Kanope/DIY_PM/Documentation/Kit/Images/Arduino.webp

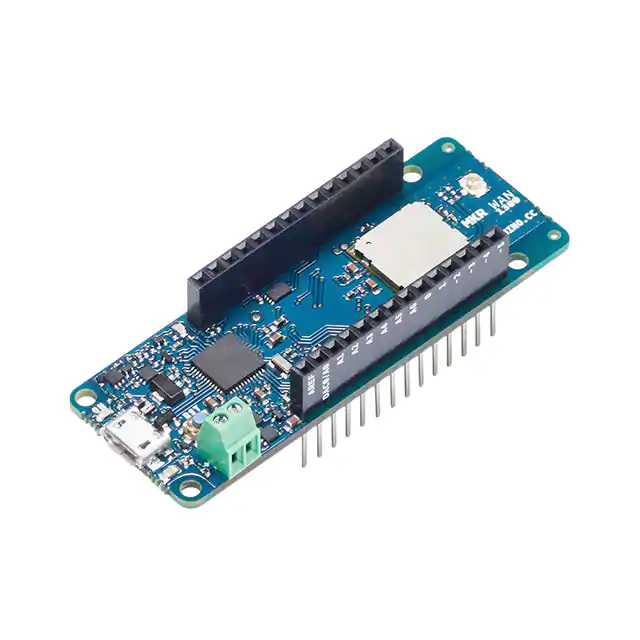
Documentation/Kit/Images/Arduino.webp
