Kanope/DIY_PM/Presentation du projet.pdf

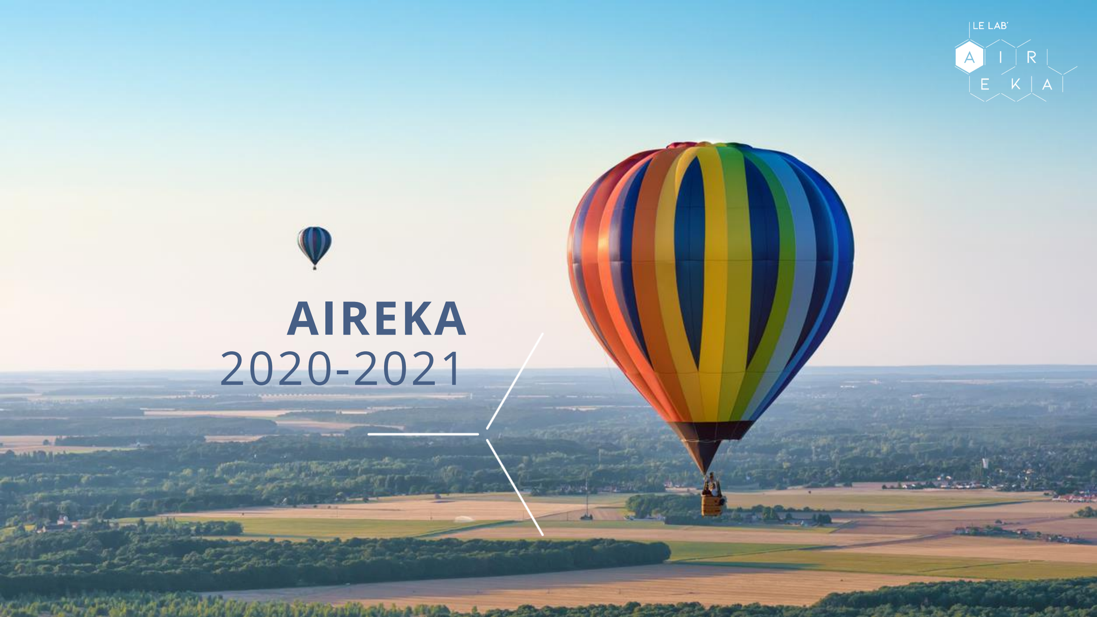
[picture p2: page 1]

## AIREKA

2020-2021

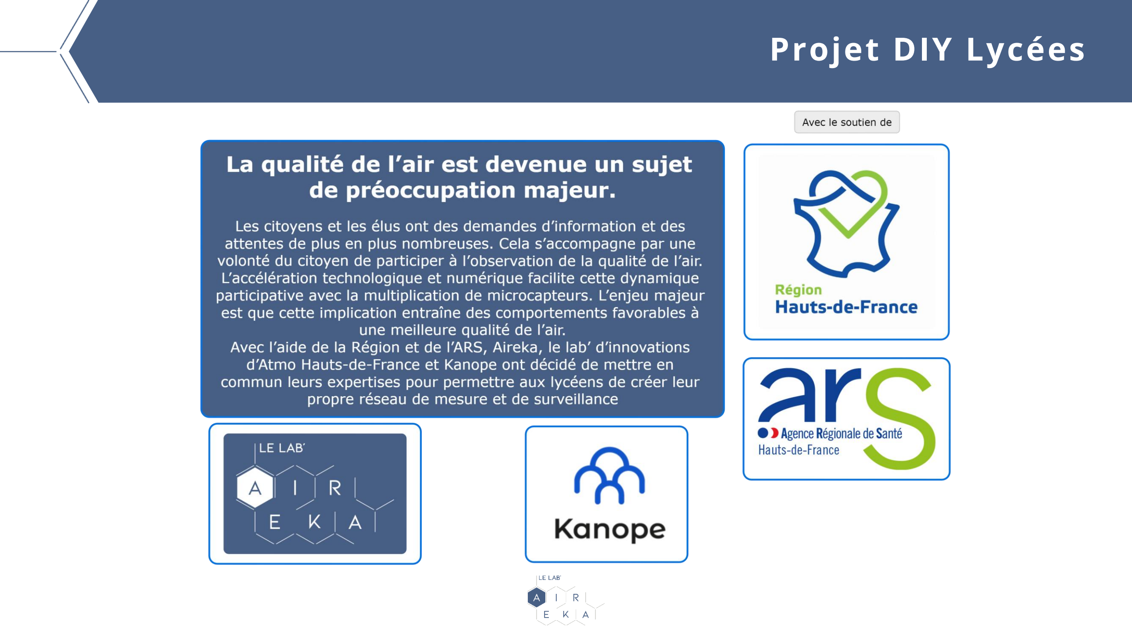
[picture p3: page 2]

Projet DIY Lycées

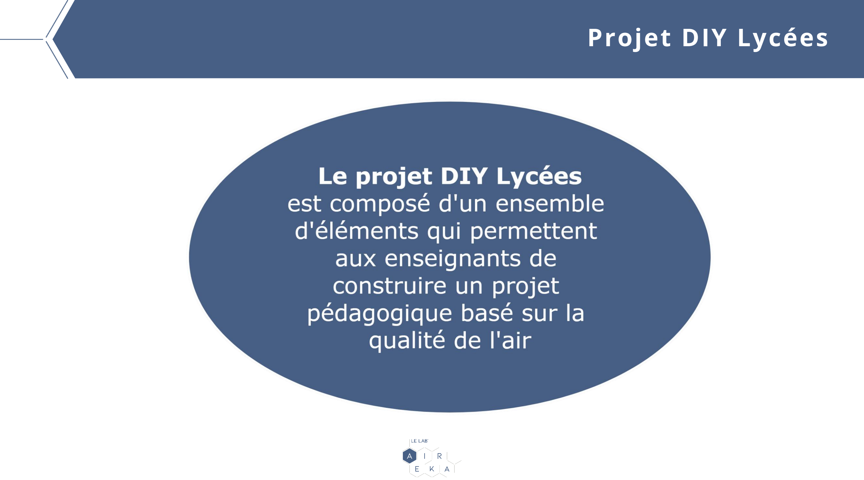
[picture p4: page 3]

Projet DIY Lycées

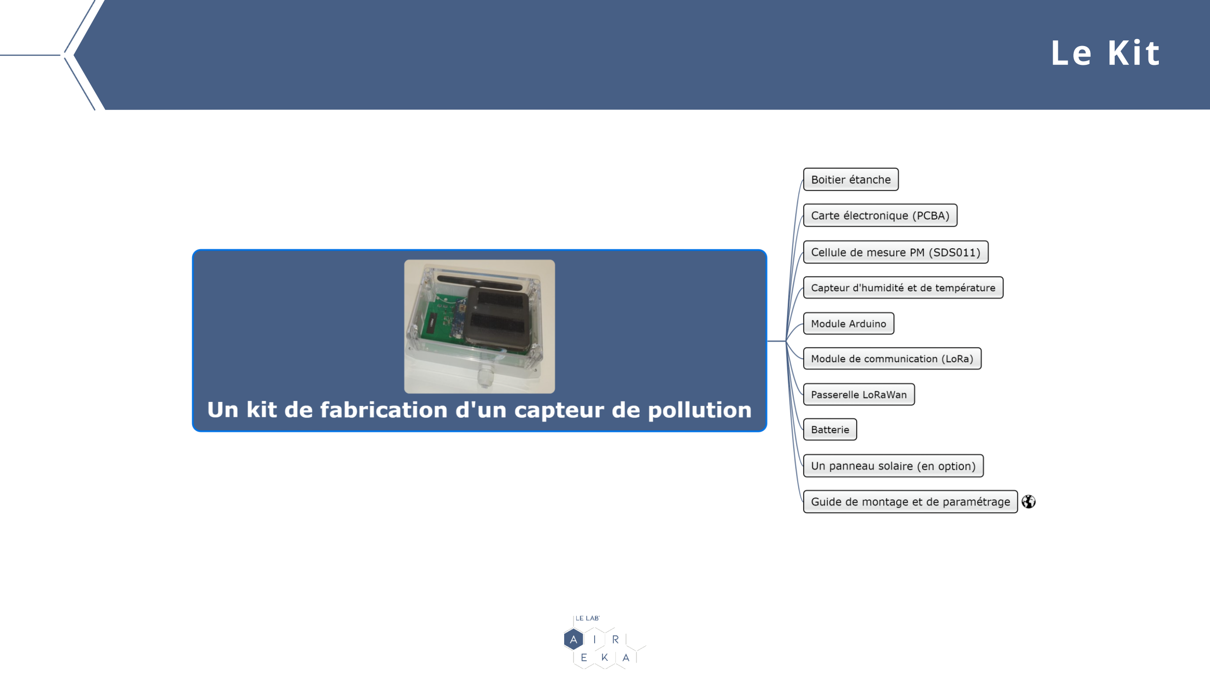
[picture p5: page 4]

Le Kit

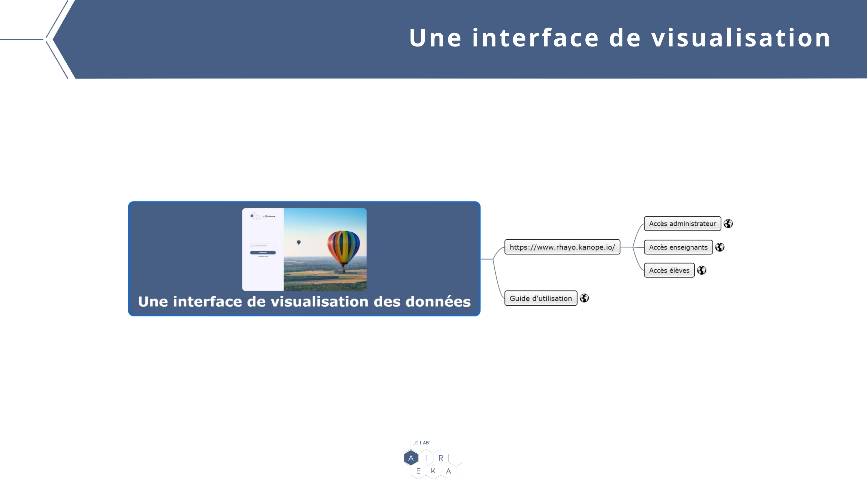
[picture p6: page 5]

Une interface de visualisation

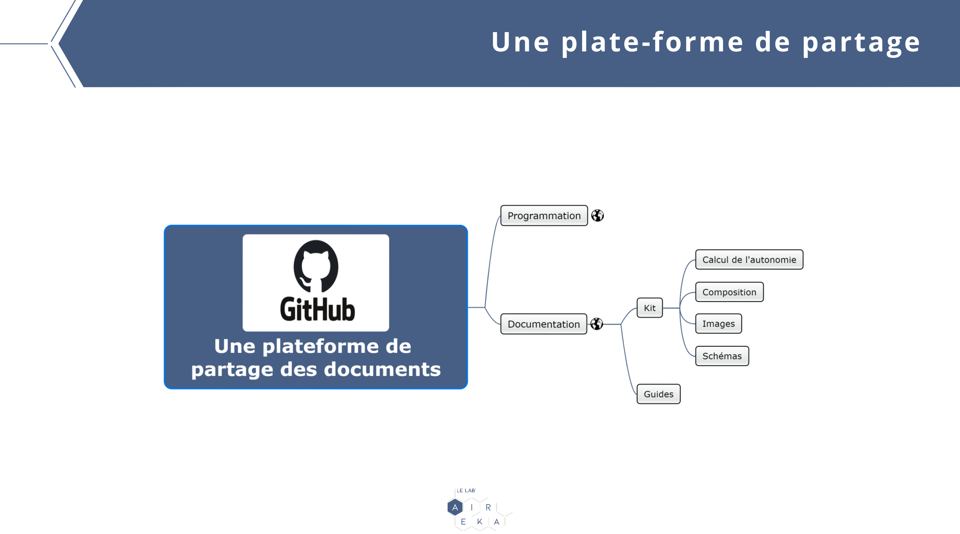
[picture p7: page 6]

Une plate-forme de partage

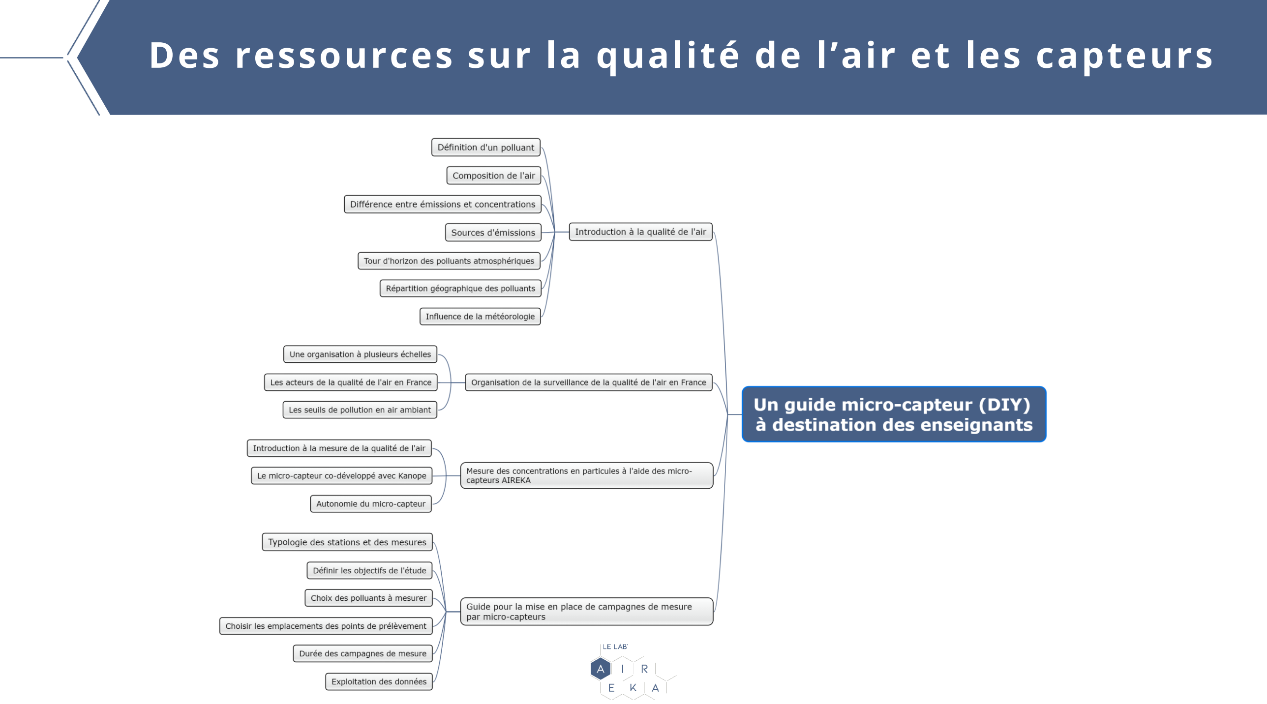
[picture p8: page 7]

Des ressources sur la qualité de l’air et les capteurs

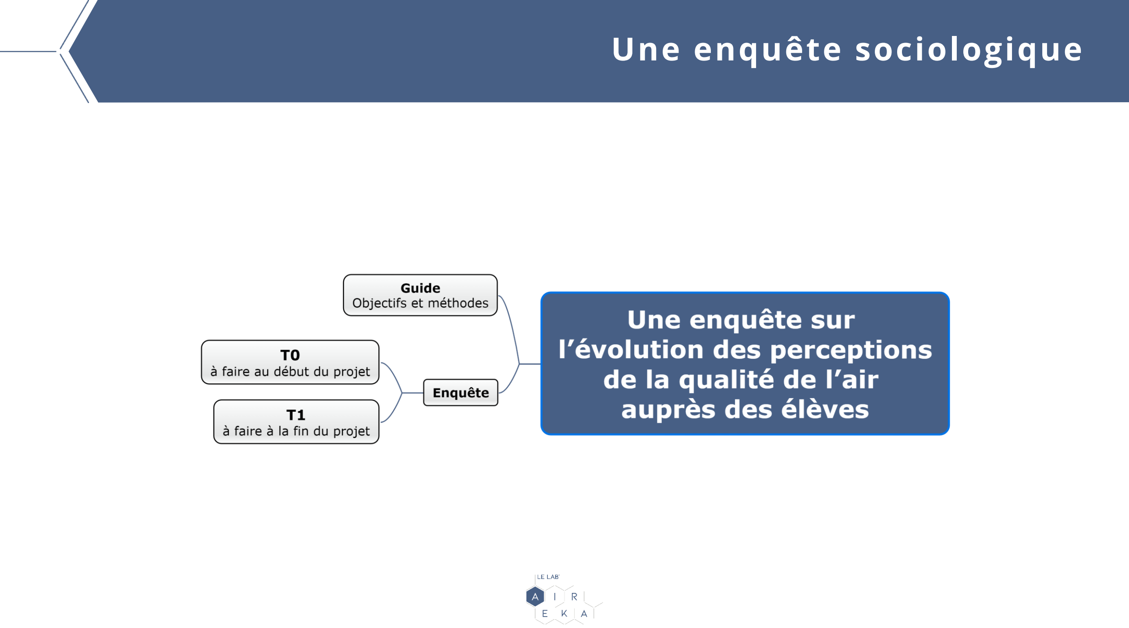
[picture p9: page 8]

Une enquête sociologique
