Kanope/DIY_PM/Documentation/Kit/Images/antenne lora.webp

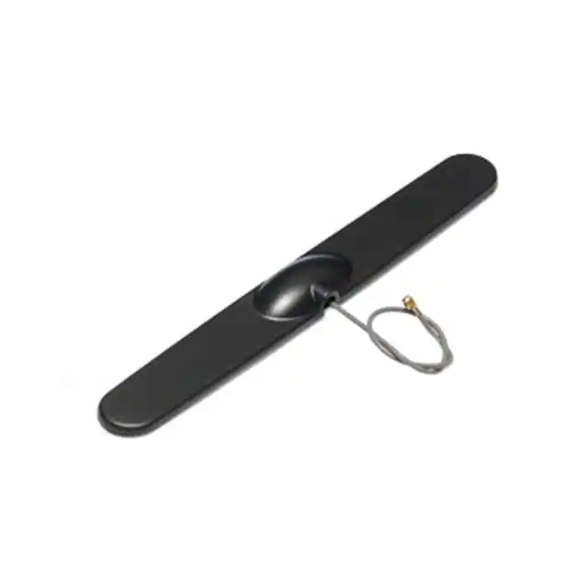
Documentation/Kit/Images/antenne lora.webp
