Kanope/DIY_PM/Documentation/Kit/Images/boitier.jpg

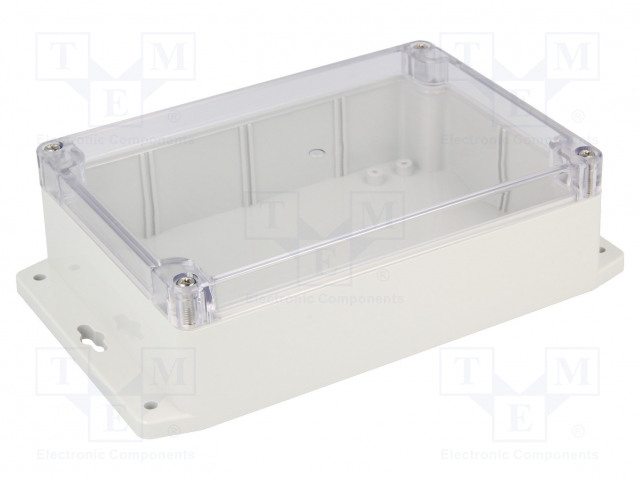
Documentation/Kit/Images/boitier.jpg
