Kanope/DIY_PM/Documentation/Kit/Images/capteur humidite-temperature.webp

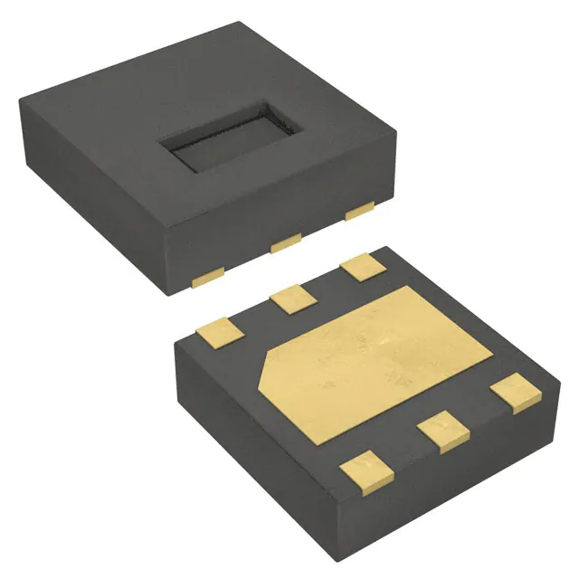
Documentation/Kit/Images/capteur humidite-temperature.webp
