Kanope/DIY_PM/Documentation/Kit/Images/cellule-mesure-SDS011.jpg

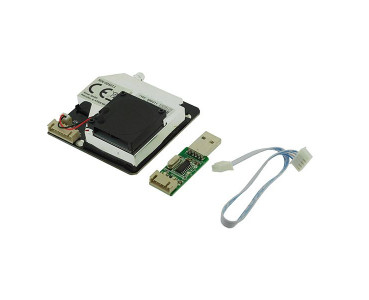
Documentation/Kit/Images/cellule-mesure-SDS011.jpg
