Kanope/DIY_PM/Documentation/Kit/Images/ecrou.webp

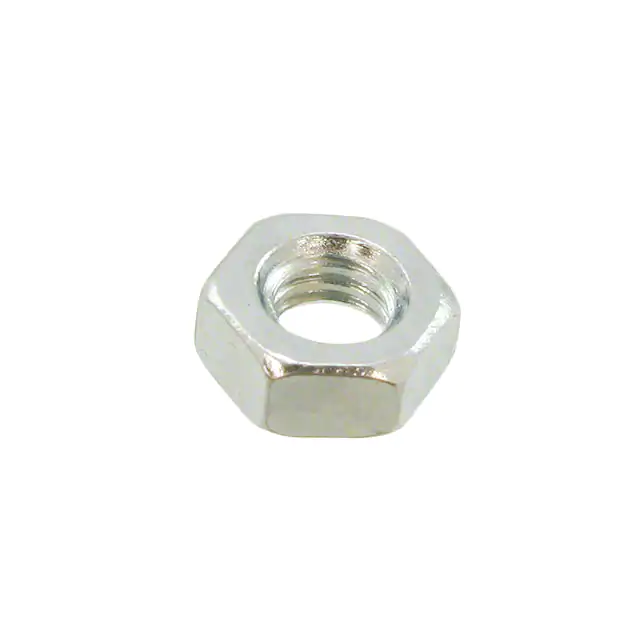
Documentation/Kit/Images/ecrou.webp
