Kanope/DIY_PM/Documentation/Kit/Images/entretoise.webp

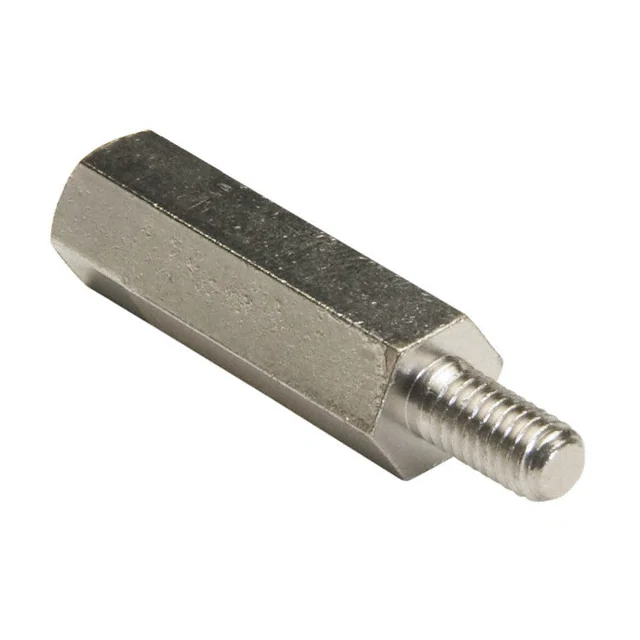
Documentation/Kit/Images/entretoise.webp
