Kanope/DIY_PM/Documentation/Kit/Images/powerbank.jpg

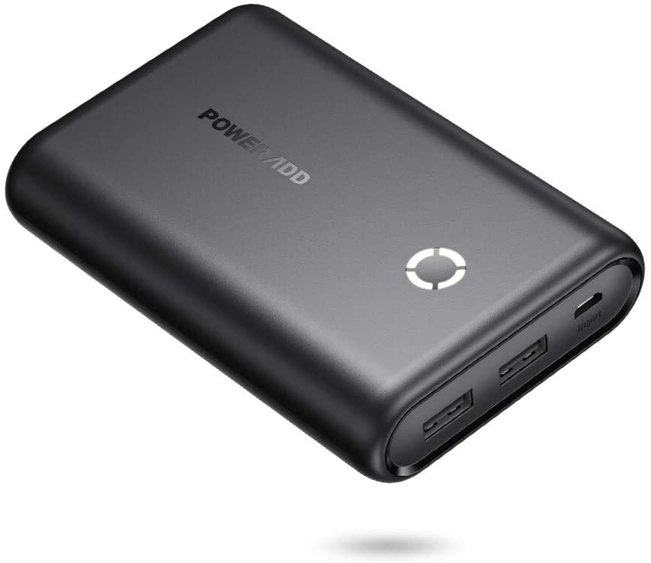
Documentation/Kit/Images/powerbank.jpg
