Kanope/DIY_PM/Documentation/Kit/Images/presse-etoupe.jpg

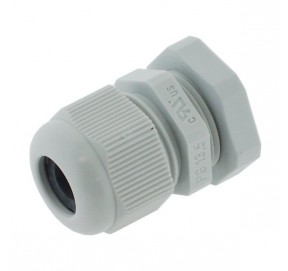
Documentation/Kit/Images/presse-etoupe.jpg
