Kanope/DIY_PM/Documentation/Kit/Images/tube.jpg

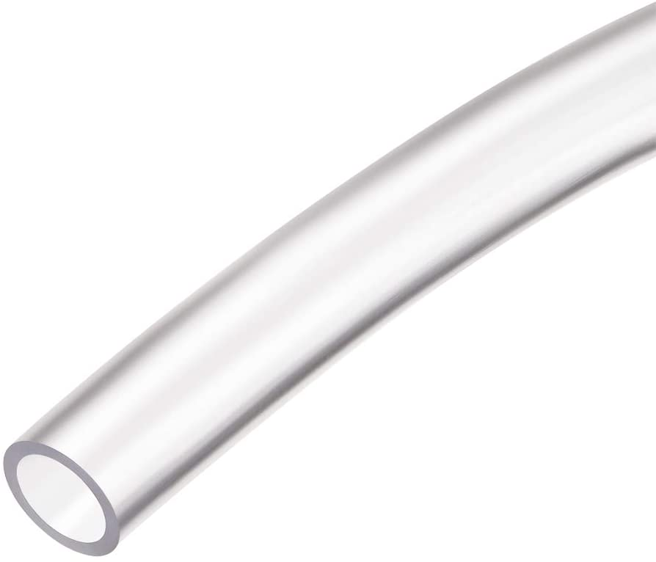
Documentation/Kit/Images/tube.jpg
