Kanope/DIY_PM/Documentation/Kit/Composition/BOM_20210106.xlsx

Référence fabricant | Fabricant | Référence Digi-Key | Référence client | Quantité | Prix unitaire | Montant | Description | Statut RoHS
RC0603FR-071KL | Yageo | 311-1.00KHRCT-ND | R9, R12 | 2 | 0,08000 | 0,16 € | RES SMD 1K OHM 1% 1/10W 0603 | Conforme à RoHS 3
RC0603FR-0710KL | Yageo | 311-10.0KHRCT-ND | R3, R4, R7, R8, R10, R11 | 6 | 0,08000 | 0,48 € | RES SMD 10K OHM 1% 1/10W 0603 | Conforme à RoHS 3
12105C106KAT2A | AVX Corporation | 478-9912-1-ND | C24, C27, C29, C30 | 4 | 0,73000 | 2,92 € | CAP CER 10UF 50V X7R 1210 | Conforme à RoHS 3
12103D226KAT2A | AVX Corporation | 478-5999-1-ND | C1, C2, C3 | 3 | 1,23000 | 3,69 € | CAP CER 22UF 25V X5R 1210 | Conforme à RoHS 3
C0603C104Z3VACTU | KEMET | 399-1100-1-ND | C4, C5, C6, C16 | 4 | 0,08000 | 0,32 € | CAP CER 0.1UF 25V Y5V 0603 | Conforme à RoHS 3
CL10A105KO8NNNC | Samsung Electro-Mechanics | 1276-1034-1-ND | C15, C25, C28 | 3 | 0,08000 | 0,24 € | CAP CER 1UF 16V X5R 0603 | Conforme à RoHS 3
2N7002K-T1-E3 | Vishay Siliconix | 2N7002K-T1-E3CT-ND | Q1 | 1 | 0,19000 | 0,19 € | MOSFET N-CH 60V 300MA SOT-23 | Conforme à RoHS 3
C0603C472K4RECAUTO | KEMET | 399-17879-1-ND | C23, C26 | 2 | 0,13000 | 0,26 € | CAP CER 0603 4.7NF 16V X7R 10% | Conforme à RoHS 3
TPS27081ADDCR | Texas Instruments | 296-34970-1-ND | U5, U6 | 2 | 0,65000 | 1,30 € | IC PWR SWITCH 1:1 TSOT23-6 | Conforme à RoHS 3
TXS0102DCTT | Texas Instruments | 296-32603-1-ND | U1 | 1 | 0,61000 | 0,61 € | IC TRNSLTR BIDIRECTIONAL SM8 | Conforme à RoHS 3
BLM18PG471SN1D | Murata Electronics | 490-5223-1-ND | L1, L2, L3 | 3 | 0,08000 | 0,24 € | FERRITE BEAD 470 OHM 0603 1LN | Conforme à RoHS 3
HPP845E031R5 | TE Connectivity Measurement Specialties | 223-1591-1-ND | U3 | 1 | 3,13000 | 3,13 € | SENSOR HUMID/TEMP 3V I2C 3% SMD | Conforme à RoHS 3
352212RJT | TE Connectivity Passive Product | A121136CT-ND | R1, R2 | 2 | 0,47000 | 0,94 € | RES SMD 12 OHM 5% 3W 2512 | Conforme à RoHS
SDS011 | 35853 | N/A | SDS1 | 1 | 34,91 | 34,91 | Detector of PM2.5;Purifier. | Conforme à RoHS 3 | https://www.gotronic.fr/art-capteur-de-qualite-de-l-air-sds011-27929.htm
0022284023 | Molex | WM50016-02-ND | P1, P2 | 2 | 0,16000 | 0,32 € | CONN HEADER VERT 2POS 2.54MM | Conforme à RoHS 3
PPTC151LFBN-RC | Sullins Connector Solutions | S7013-ND | JP1, JP2 | 2 | 3,88000 | 7,76 € | CONN HEADER VERT 15POS 2.54MM | Conforme à RoHS
61300511121 | Würth Elektronik | 732-5318-ND | J1 | 1 | 0,21000 | 0,21 € | CONN HEADER VERT 5POS 2.54MM | Conforme à RoHS 3
PH1-07-UA | Adam Tech | 2057-PH1-07-UA-ND | J2 | 1 | 0,11000 | 0,11 € | CONN HEADER VERT 7POS 2.54MM | Conforme à RoHS 3
R30-3002002 | Harwin Inc. | 952-1510-ND | standoff | 3 | 0,67000 | 2.01 € | HEX STANDOFF M3X0.5 BRASS 20MM | Conforme à RoHS 3
RM3X6MM 2701 | APM Hexseal | 335-1156-ND | vis | 10 | 0,33800 | 3.38 € | MACH SCREW PAN HEAD PHILLIPS M3 | Conforme à RoHS 3
MHNZ 003 | B&F Fastener Supply | H762-ND | ecrou | 100 | 0,03570 | 3.57 € | HEX NUT 0.217" M3 | Non conforme à RoHS
G214CMF | G214CMF | N/A | N/A | 1 | 6,69 | 6.69 € | Enclosure 171x121x55 IP65 Waterproof | Conforme à RoHS 3 | https://www.tme.eu/fr/en/details/g214cmf/multipurpose-enclosures/gainta/
G223CMF | G223CMF | N/A | N/A | 1 | 10.01 | 10.01 | Enclosure 171x121x55 IP65 Waterproof | Conforme à RoHS 3 | https://www.tme.eu/fr/en/details/g223cmf/multipurpose-enclosures/gainta/
We can choose the right box depending of the power bank size
