Kanope/DIY_PM/Documentation/Kit/Schémas/arduino-mkr-1300-wan.step

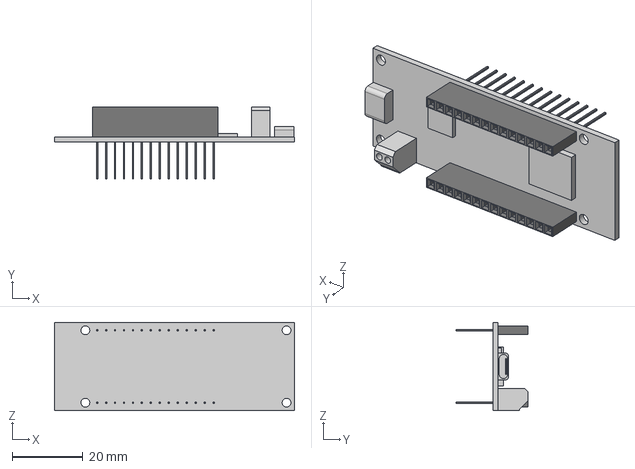
[picture p19: CAD file, 2021-02-05]
Documentation/Kit/Schémas/arduino-mkr-1300-wan.step
68.0 x 20.5 x 25.0 mm
pcb
14-pin-header x 2
