Kanope/DIY_PM/Documentation/Kit/Schémas/PMsensor.step

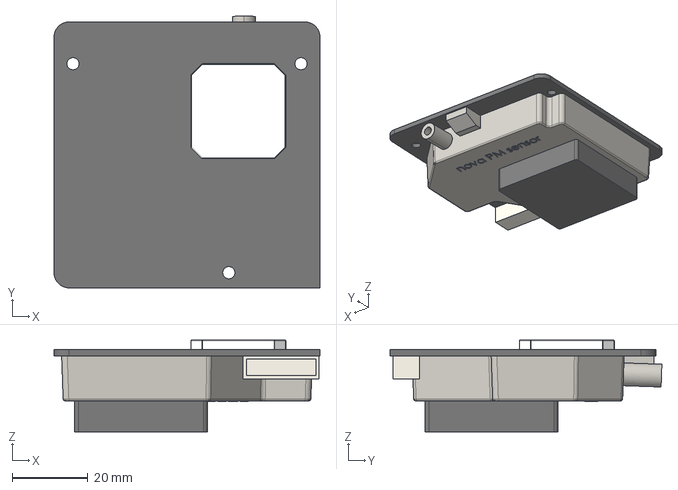
[picture p20: CAD file, 2021-02-05]
Documentation/Kit/Schémas/PMsensor.step
70.0 x 71.5 x 24.2 mm
