Kanope/DIY_PM/Documentation/Kit/Schémas/DIY.step

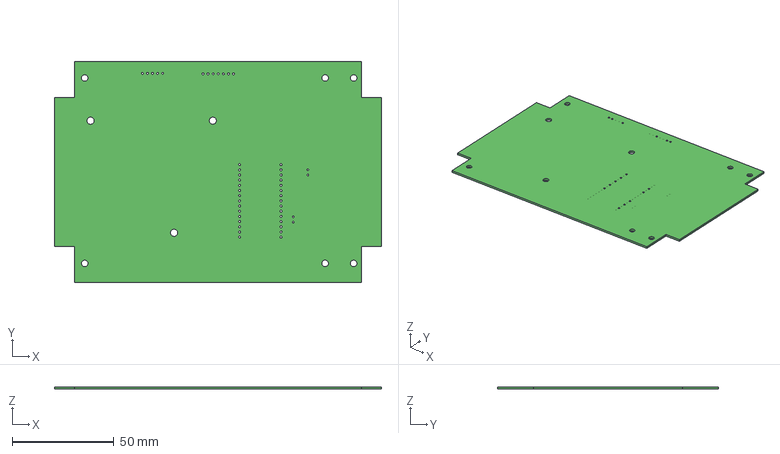
[picture p21: CAD file, 2021-02-05]
Documentation/Kit/Schémas/DIY.step
160.5 x 108.6 x 1.12 mm
