Kanope/DIY_PM/Documentation/Kit/Schémas/humidity.step

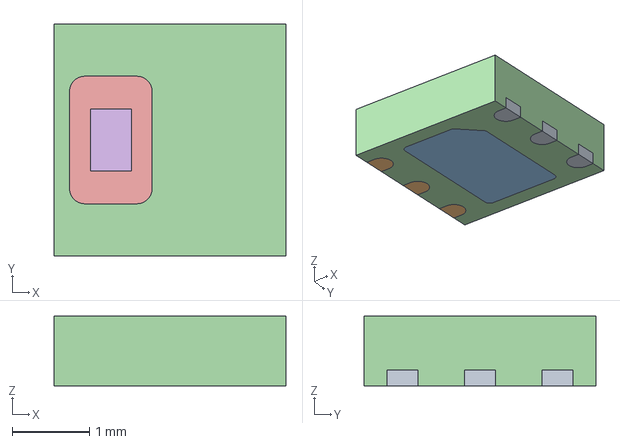
[picture p22: CAD file, 2021-02-05]
Documentation/Kit/Schémas/humidity.step
3.00 x 3.00 x 0.9 mm
