Kanope/DIY_PM/Documentation/Guides/Figer adresse ip passerelle LoRa.pdf

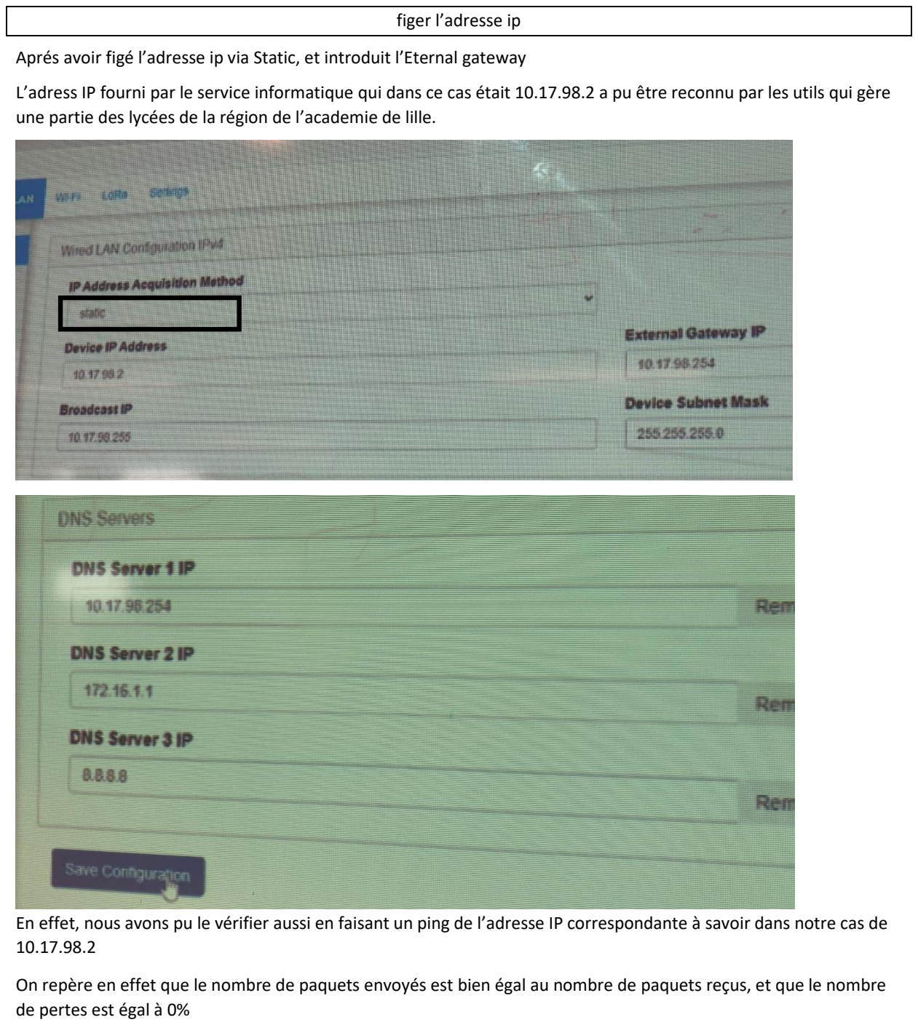
[picture p114: page 1]

figer l’adresse ip

Aprés avoir figé l’adresse ip via Static, et introduit l’Eternal gateway

L’adress IP fourni par le service informatique qui dans ce cas était 10.17.98.2 a pu être reconnu par les utils qui gère une partie des lycées de la région de l’academie de lille.

En effet, nous avons pu le vérifier aussi en faisant un ping de l’adresse IP correspondante à savoir dans notre cas de 10.17.98.2

On repère en effet que le nombre de paquets envoyés est bien égal au nombre de paquets reçus, et que le nombre de pertes est égal à 0%

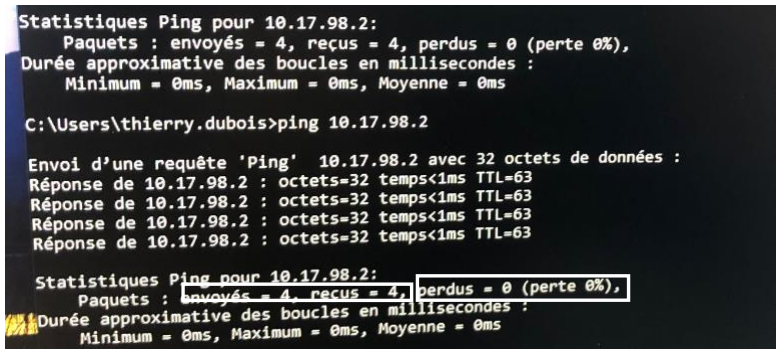
[picture p115: figure]
