Kanope/DIY_PM/Documentation/Kit/Schémas/Schematic.pdf

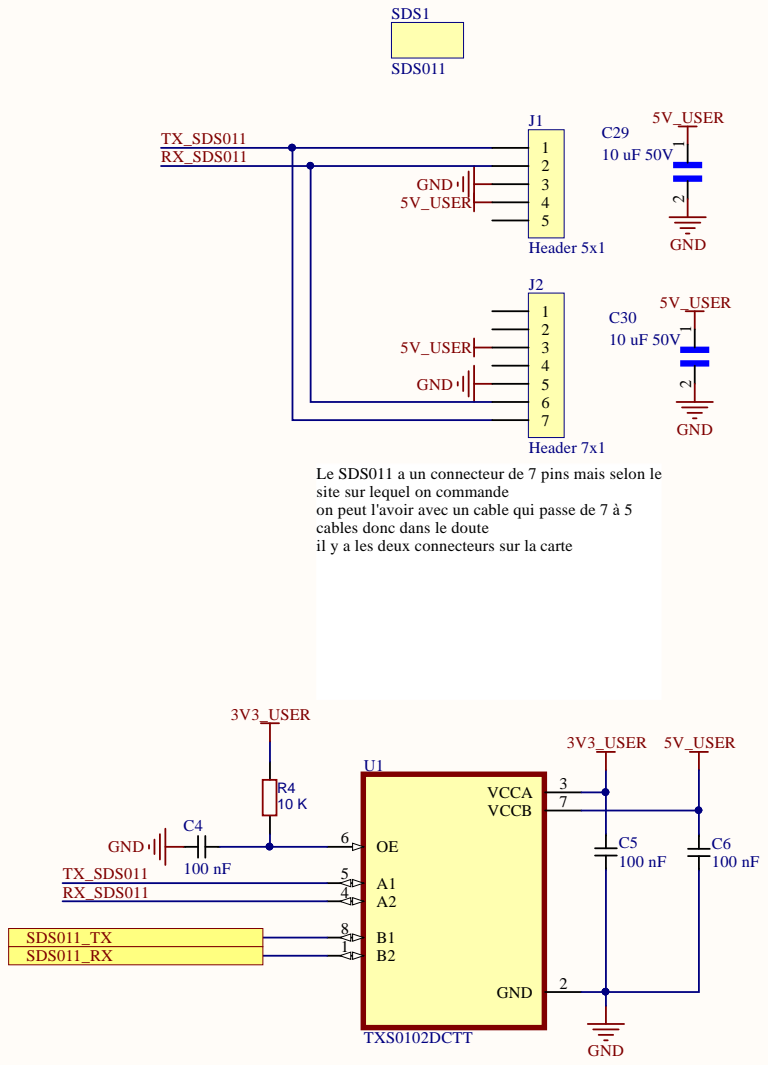
[picture p120: page 1]

Le SDS011 a un connecteur de 7 pins mais selon le
site sur lequel on commande
on peut l'avoir avec un cable qui passe de 7 à 5
cables donc dans le doute
il y a les deux connecteurs sur la carte

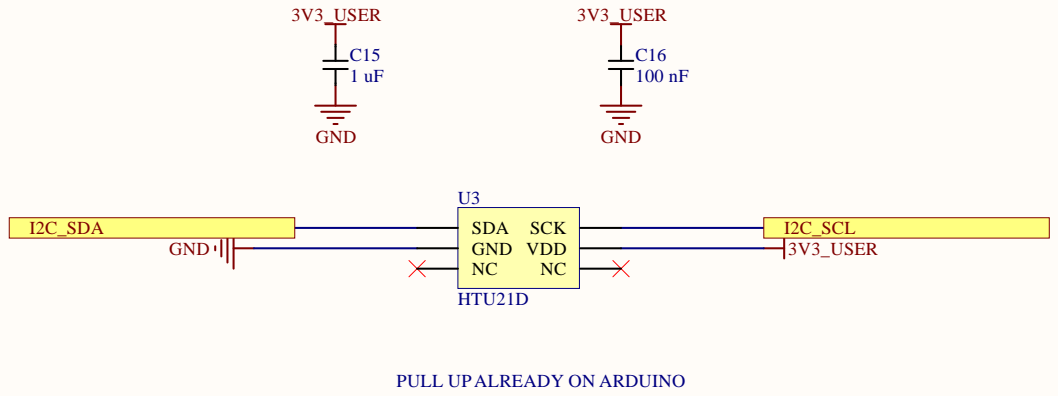
[picture p121: page 2]

PULL UP ALREADY ON ARDUINO

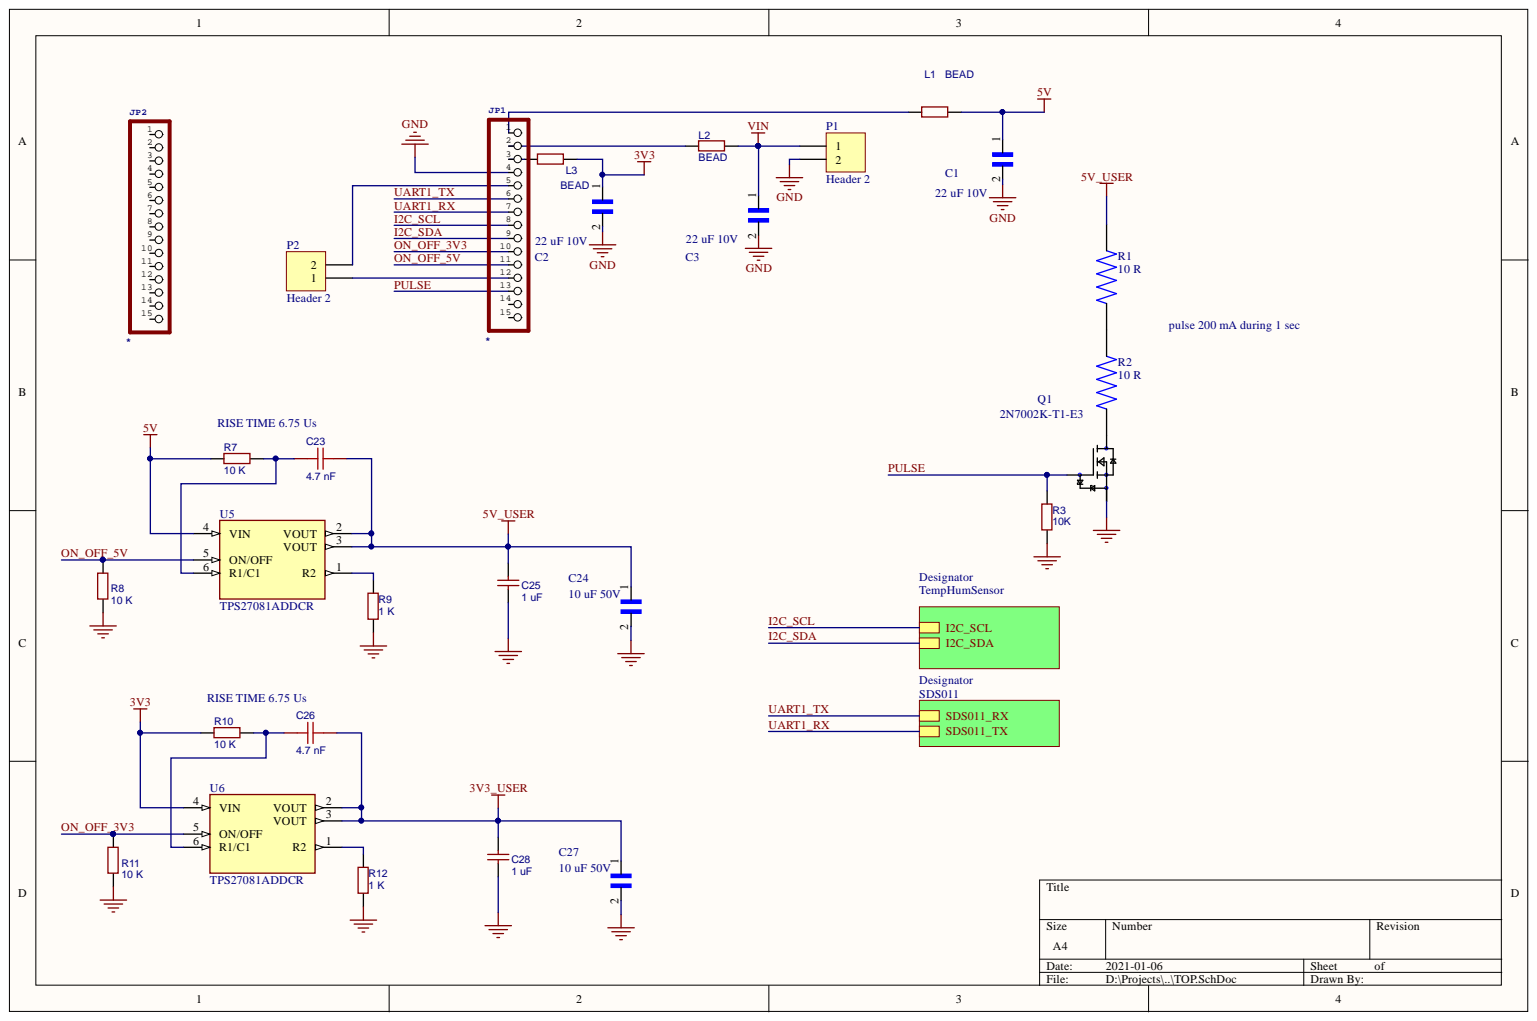
[picture p122: page 3]

pulse 200 mA during 1 sec

VIN 4

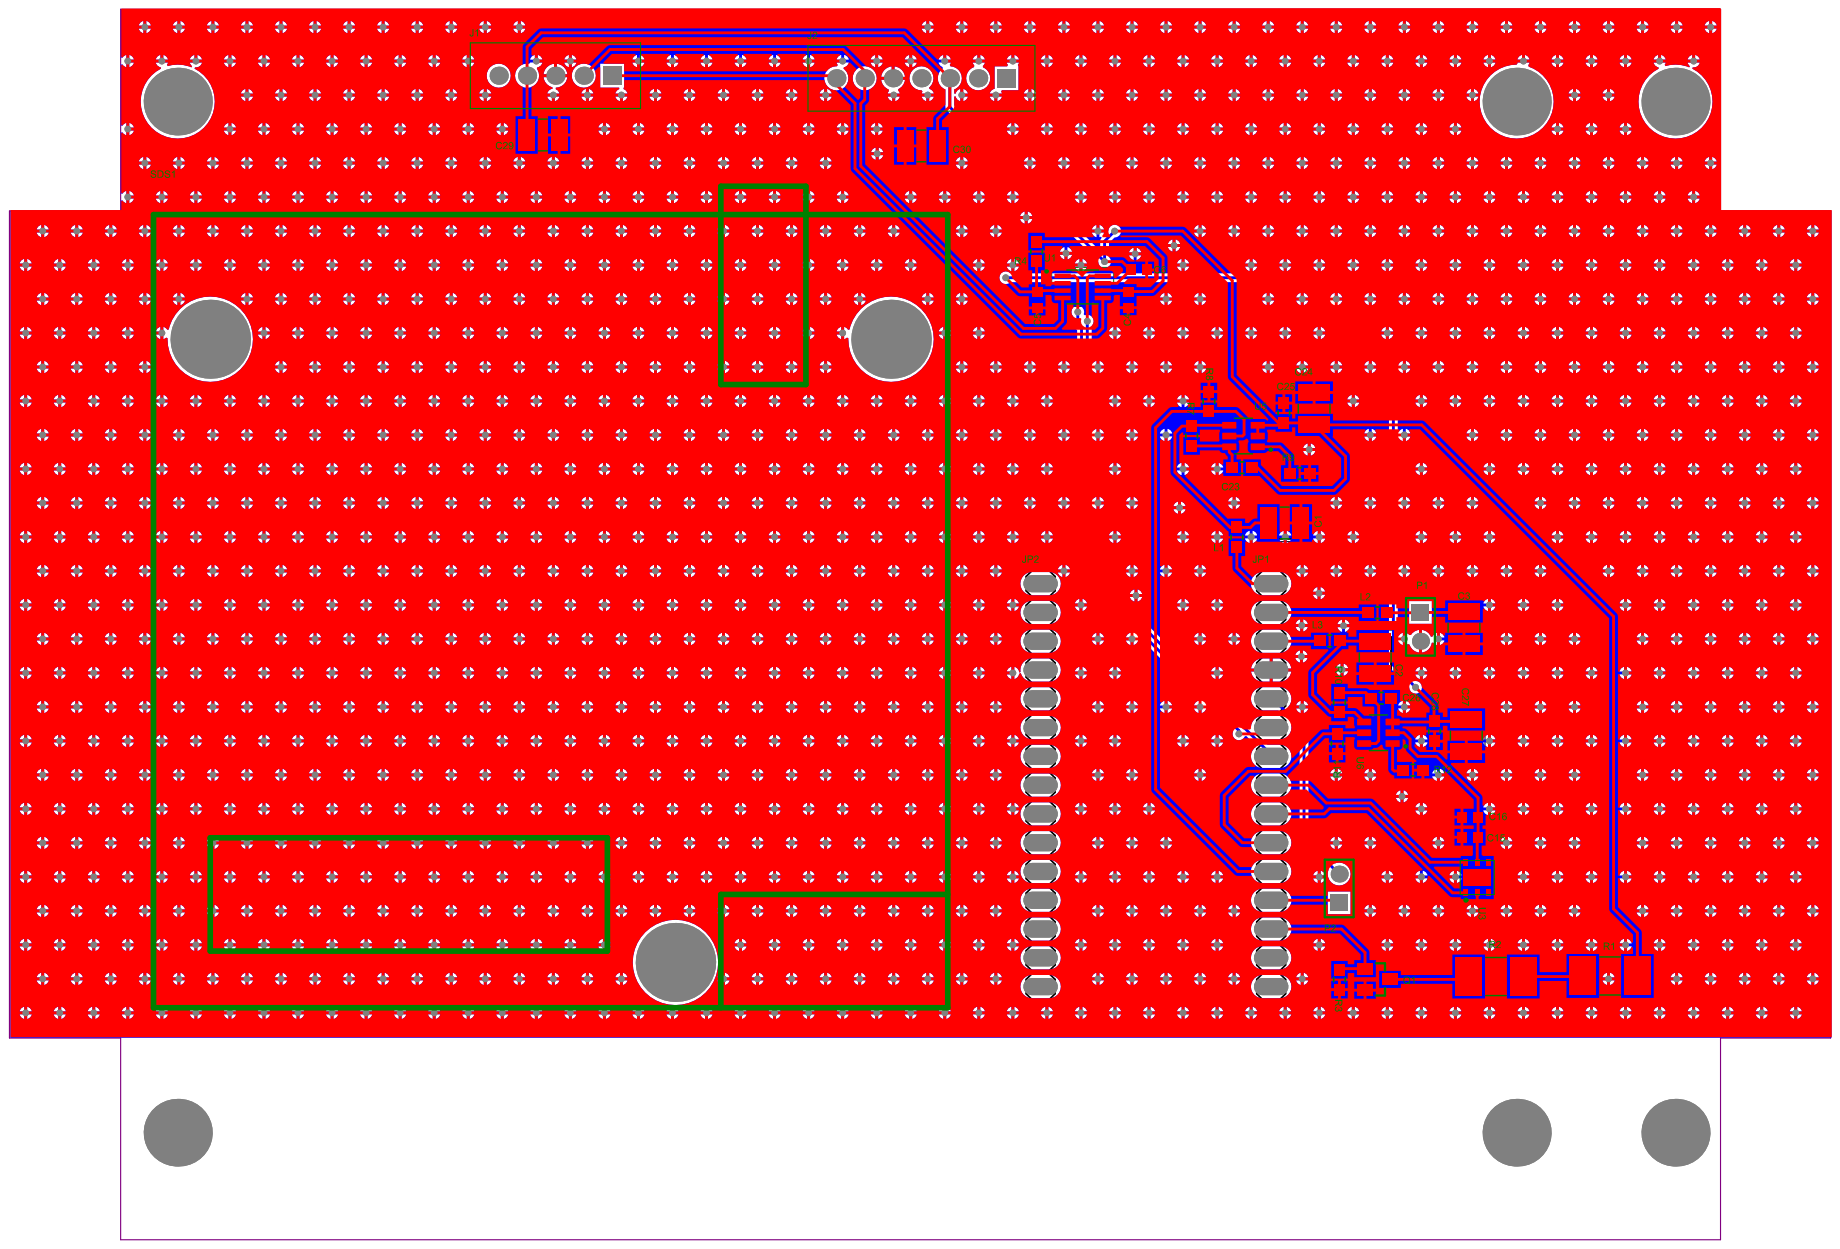
[picture p123: page 4]
