Kanope/DIY_PM/Carte mentale du projet DIY Lycées.pdf

# La qualité de l’air est devenue un sujet

de préoccupation majeur.

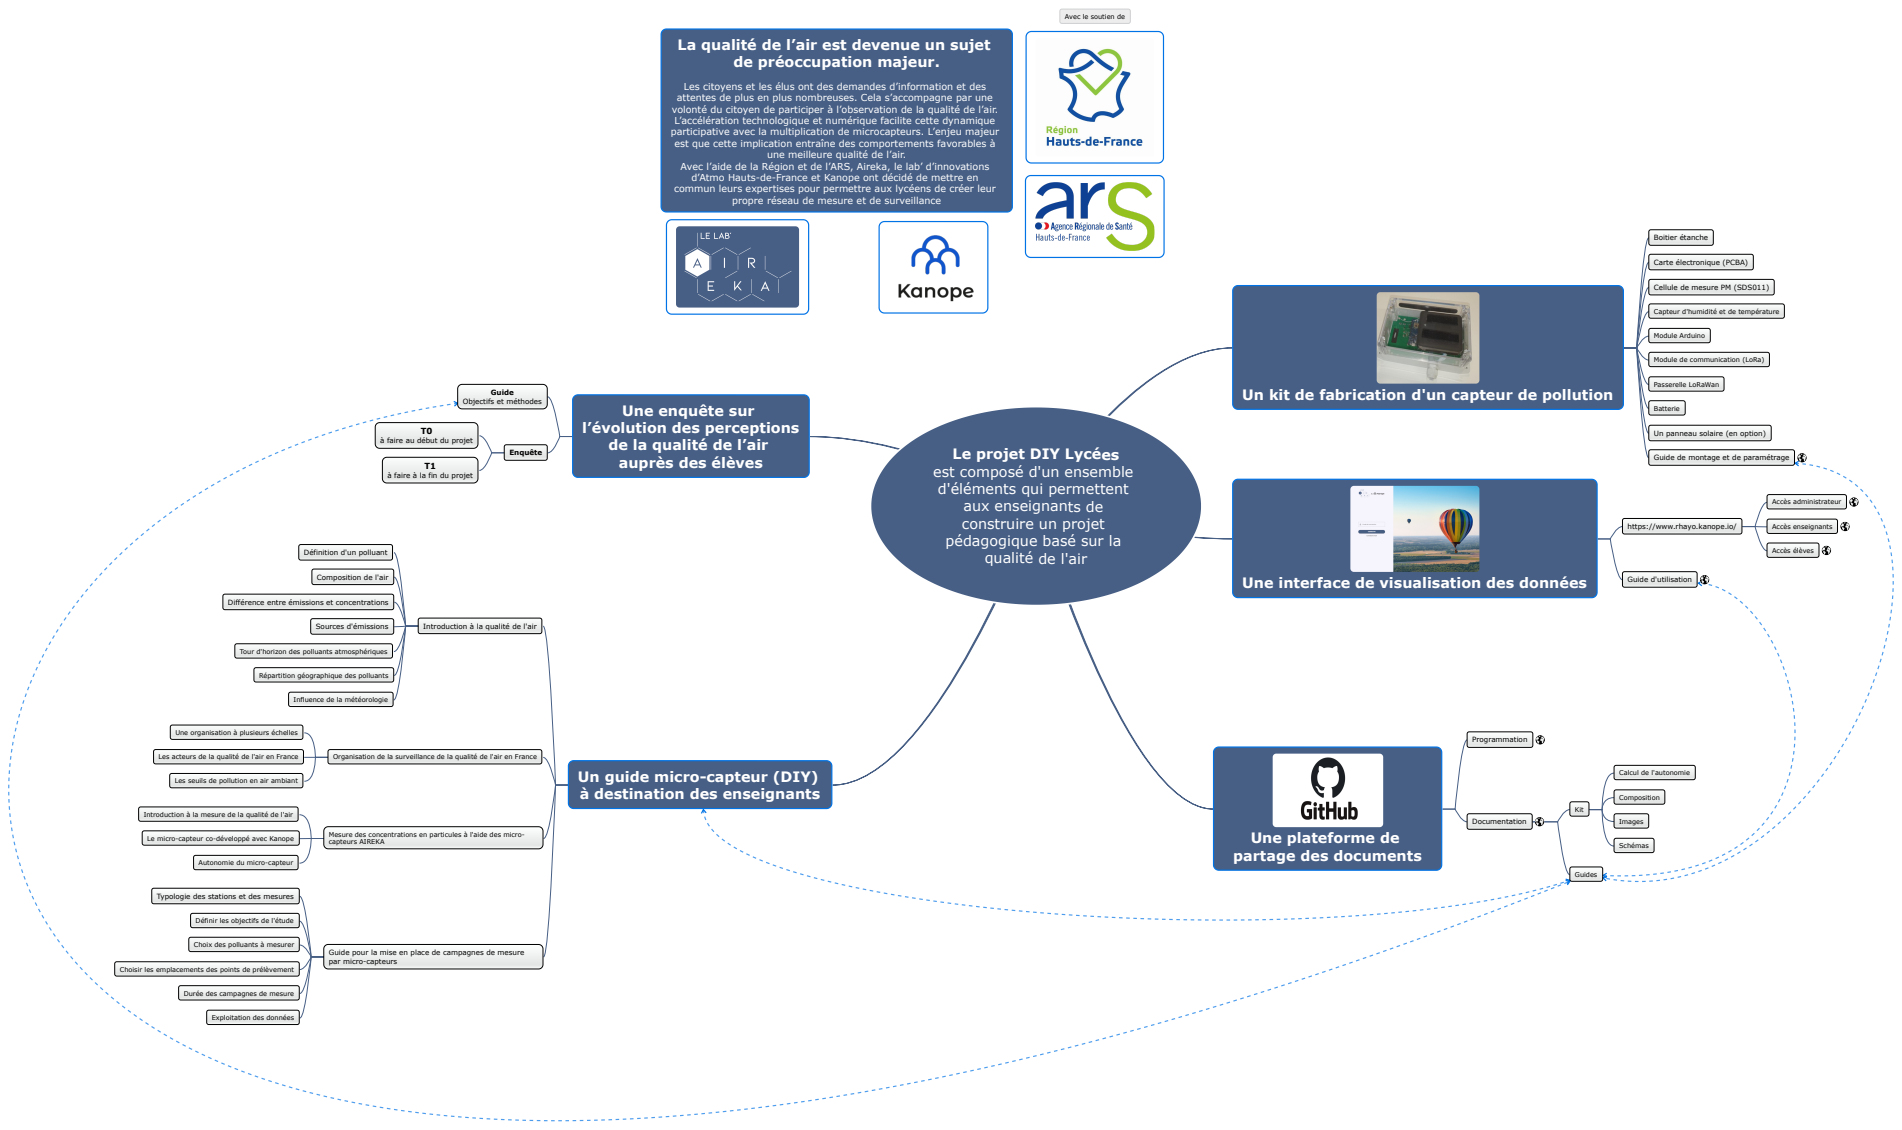
[picture p124: page 1]
Boitier étanche; Module Arduino; Passerelle LoRaWan; Batterie; Guide de montage et de paramétrage; Accès administrateur; Accès enseignants; Accès élèves; Guide d'utilisation; Programmation; Documentation; Kit; Composition; Images; Schémas; Guides; Guide; Enquête; Sources d'émissions

Avec le soutien de

Les citoyens et les élus ont des demandes d’information et des
attentes de plus en plus nombreuses. Cela s’accompagne par une
volonté du citoyen de participer à l’observation de la qualité de l’air.
L’accélération technologique et numérique facilite cette dynamique
participative avec la multiplication de microcapteurs. L’enjeu majeur
est que cette implication entraîne des comportements favorables à

une meilleure qualité de l’air.

Avec l’aide de la Région et de l’ARS, Aireka, le lab’ d’innovations
d’Atmo Hauts-de-France et Kanope ont décidé de mettre en
commun leurs expertises pour permettre aux lycéens de créer leur

propre réseau de mesure et de surveillance

Carte électronique (PCBA)

Cellule de mesure PM (SDS011)

Capteur d'humidité et de température

Module de communication (LoRa)

Un kit de fabrication d'un capteur de pollution

Objectifs et méthodes

Une enquête sur
l’évolution des perceptions
de la qualité de l’air
auprès des élèves

Un panneau solaire (en option)

à faire au début du projet

Le projet DIY Lycées
est composé d'un ensemble
d'éléments qui permettent
aux enseignants de
construire un projet
pédagogique basé sur la
qualité de l'air

à faire à la fin du projet

https://www.rhayo.kanope.io/

Définition d'un polluant

Composition de l'air

Une interface de visualisation des données

Différence entre émissions et concentrations

Introduction à la qualité de l'air

Tour d'horizon des polluants atmosphériques

Répartition géographique des polluants

Influence de la météorologie

Une organisation à plusieurs échelles

Les acteurs de la qualité de l'air en France

Organisation de la surveillance de la qualité de l'air en France

Un guide micro-capteur (DIY)
à destination des enseignants

Calcul de l'autonomie

Les seuils de pollution en air ambiant

Introduction à la mesure de la qualité de l'air

Mesure des concentrations en particules à l'aide des micro-
capteurs AIREKA

Une plateforme de
partage des documents

Le micro-capteur co-développé avec Kanope

Autonomie du micro-capteur

Typologie des stations et des mesures

Définir les objectifs de l'étude

Choix des polluants à mesurer

Guide pour la mise en place de campagnes de mesure
par micro-capteurs

Choisir les emplacements des points de prélèvement

Durée des campagnes de mesure

Exploitation des données
