Kanope/DIY_PM/(commit log)

2021-02-05 First commit new git
    [BOM_20210106.xlsx, Battery.xlsx, DIY.step, PMsensor.step, arduino-mkr-1300-wan.step, humidity.step]
2021-02-09 - Add some explains about libraries installation. - Fix the link for download Arduino. - Add a new step for hardware setup which is add a hole for solar panel.
2021-02-11 Rename
    Nouveau nom de fichier
2021-02-11 Réorganisation des fichiers
    [BOM_20210106.xlsx, Battery.xlsx, DIY.step, PMsensor.step, arduino-mkr-1300-wan.step, humidity.step]
2021-02-11 Renommage de fichiers
2021-02-15 Battery.xls adjust value with the correct power bank.
    [Battery.xlsx]
2022-01-19 feat: Add configuration pin feat: Send a query instead of read all time
2022-02-01 Feat: Add deviceEui print. Feat: Replace hard reset by softReset.
    [app.ino]
2022-02-01 Feat: Add configuration pin to test within 10 sec
2022-02-01 chore: rename Programmatio repo to app repo. feat: add print for appEUI, deviceEUI, appKEY.
2022-02-25 Documentation version Upgrade to 1.2. Remove gateway section. Add some details about assembly (more pictures).
2022-03-09 Modification du document guide de montage du kit
2022-03-09 Documentation update concerning assembling.
